mcleinn/openxen/docs/input/lekker-1.jpg

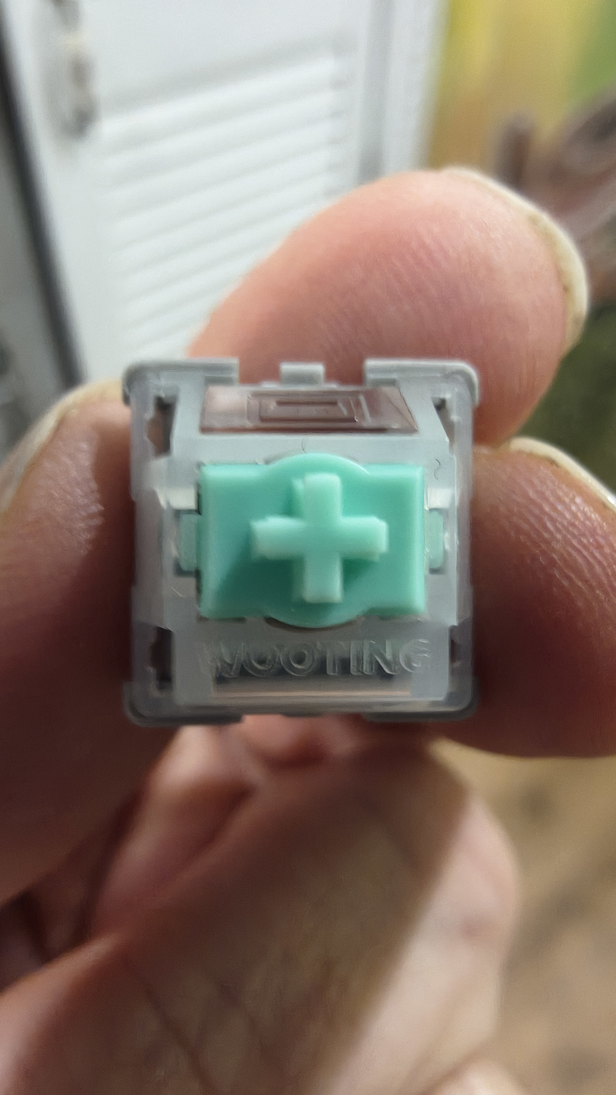
docs/input/lekker-1.jpg
