mcleinn/openxen/docs/input/lekker-2.jpg

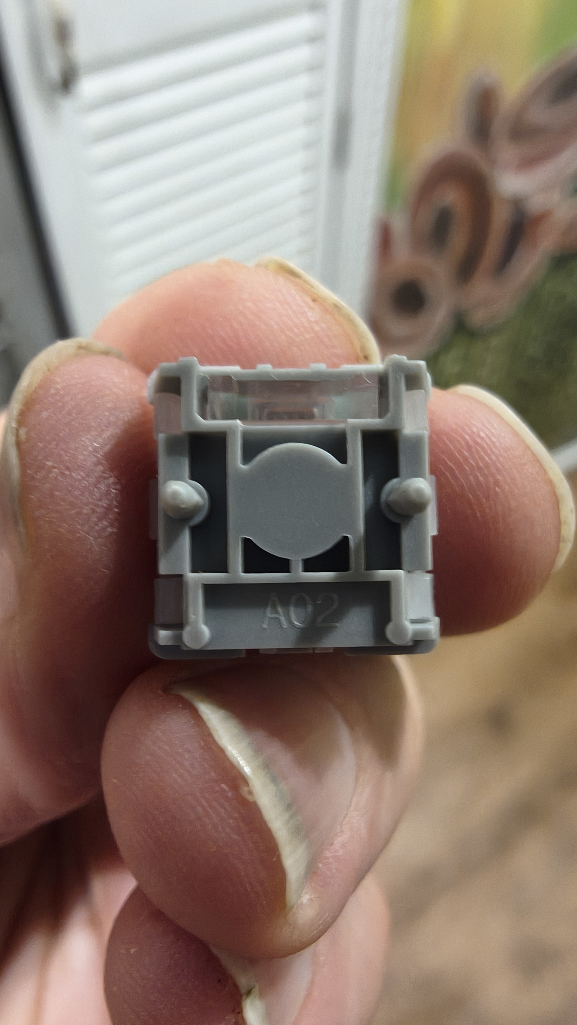
docs/input/lekker-2.jpg
