mcleinn/openxen/case/README.md

# case — deltas against the freexen case

The wood case and the five 1.5 mm CNC plates from freexen are reused. This folder will hold only what changes: floor-plate thickness, USB-C bay cutouts, printed spacers.
