mcleinn/openxen/host/README.md

# host — xentool backend notes

The host code lives in `C:\Dev-Free\xentool` (new `src/openxen/` backend, Phase 8). This folder holds the protocol description shared between firmware and host once defined.
