mcleinn/openxen/docs/input/case-1.jpg

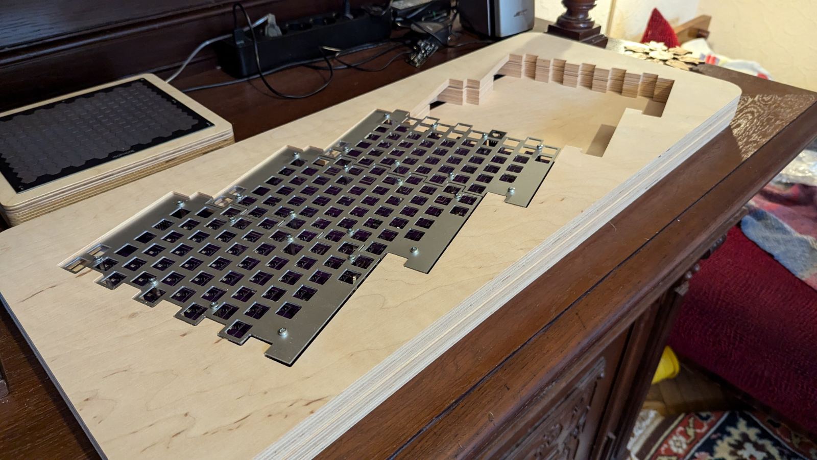
docs/input/case-1.jpg
