mcleinn/openxen/docs/input/case-2.jpg

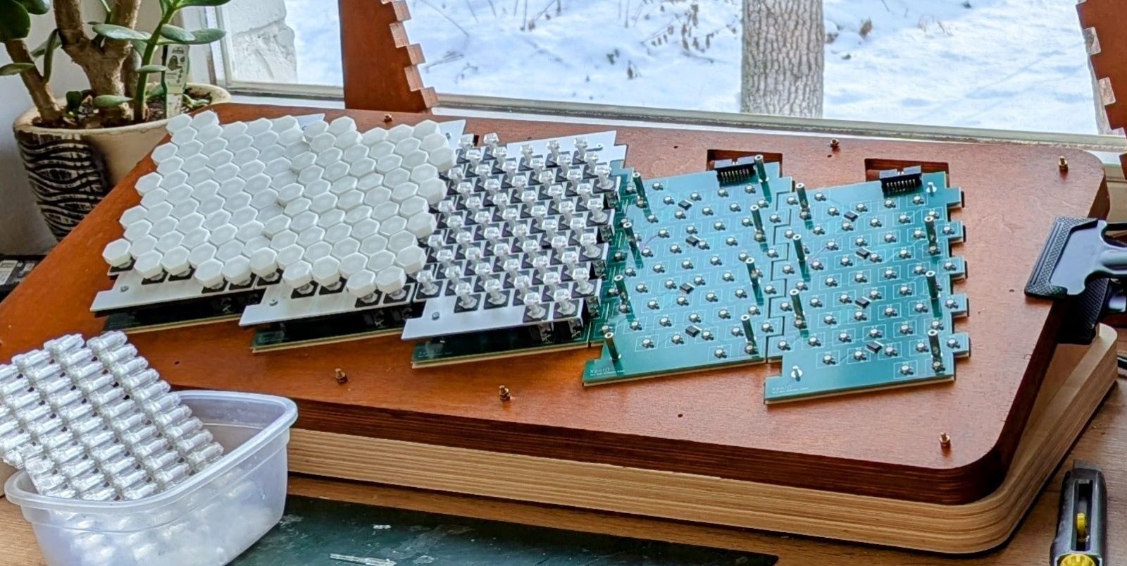
docs/input/case-2.jpg
