mcleinn/openxen/layout/geometry_check.png

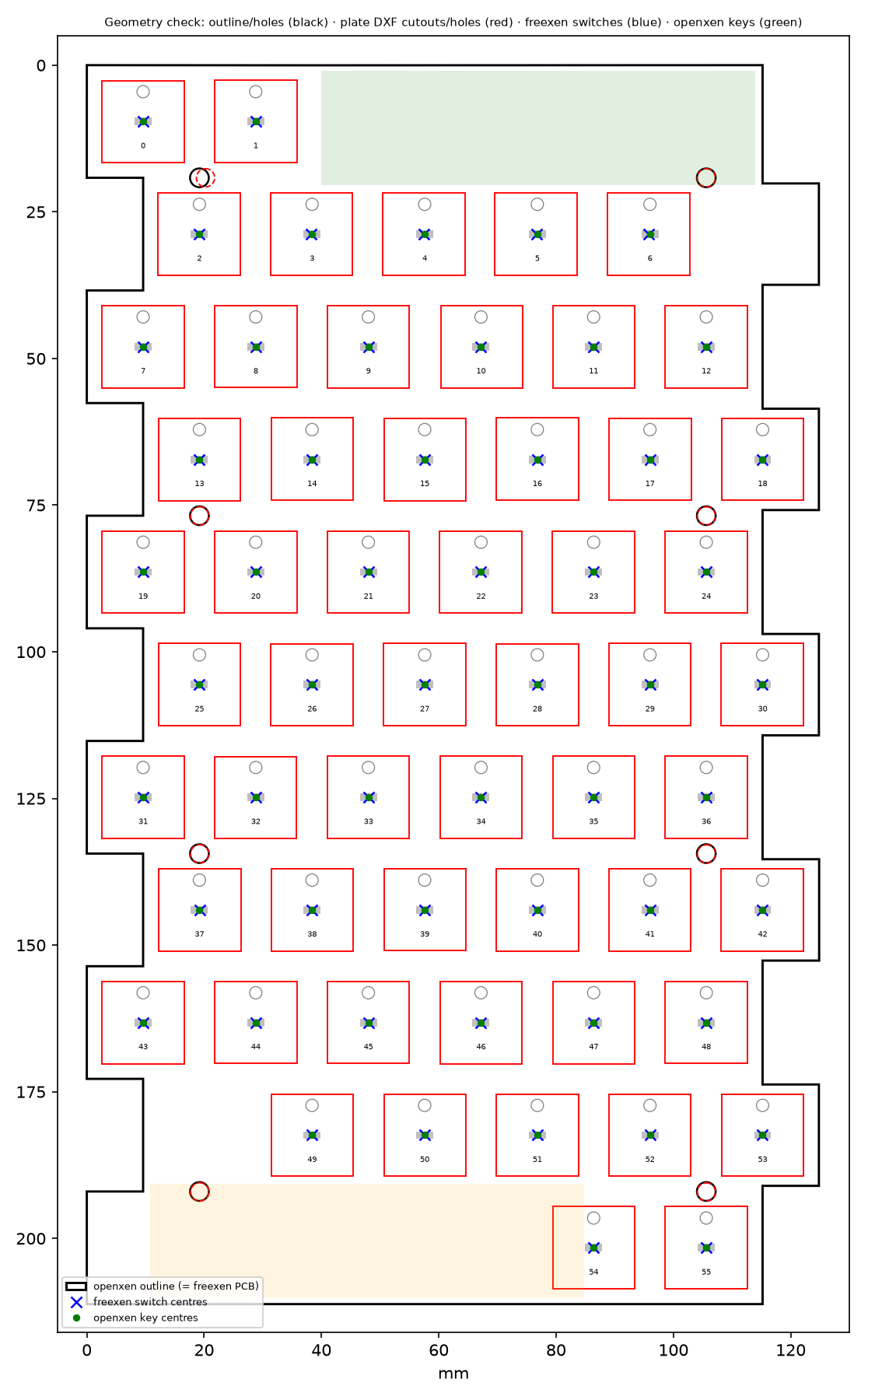
layout/geometry_check.png
