mcleinn/openxen/layout/module_preview.png

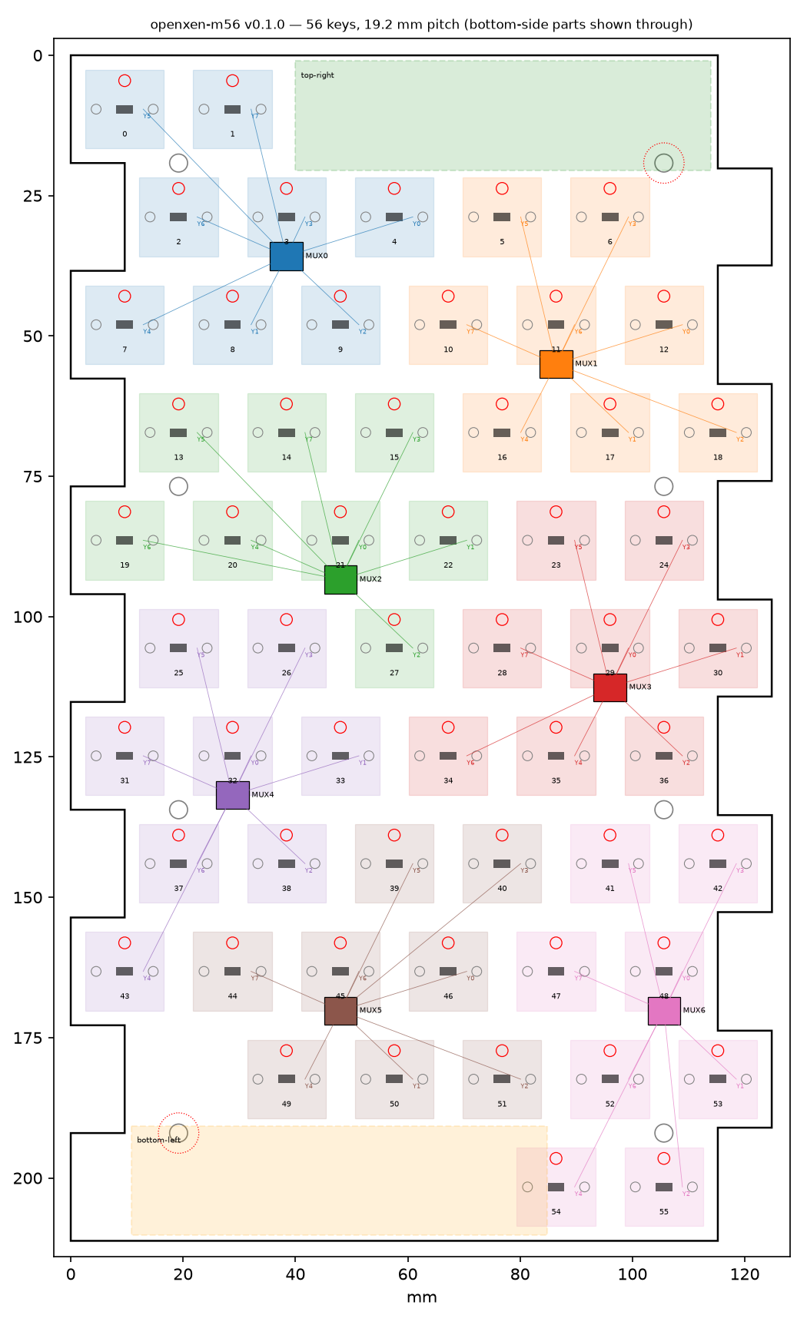
layout/module_preview.png
