mcleinn/openxen/hardware/kicad/openxen-m56/openxen-m56.kicad_pcb

## KiCad design hardware/kicad/openxen-m56/openxen-m56.kicad_pcb (2026-11-07)

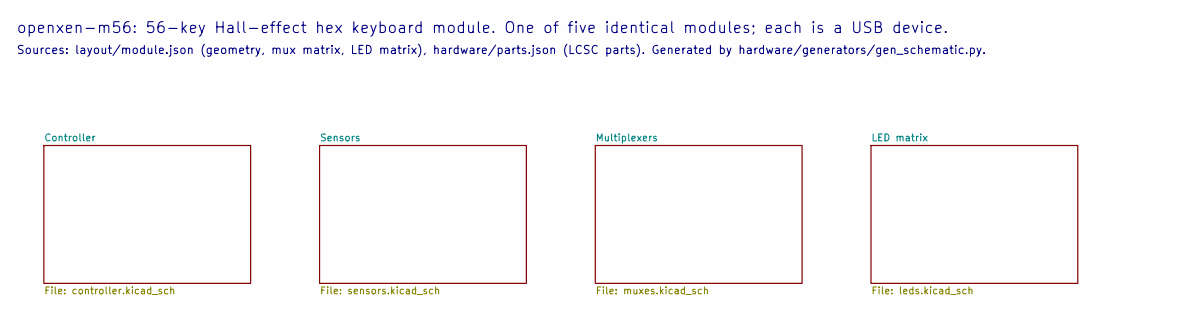
[picture p7: schematic openxen-m56.kicad_sch, openxen-m56 module]

Notes on the sheet:
openxen-m56: 56-key Hall-effect hex keyboard module. One of five identical modules; each is a USB device.
Sources: layout/module.json (geometry, mux matrix, LED matrix), hardware/parts.json (LCSC parts). Generated by hardware/generators/gen_schematic.py.

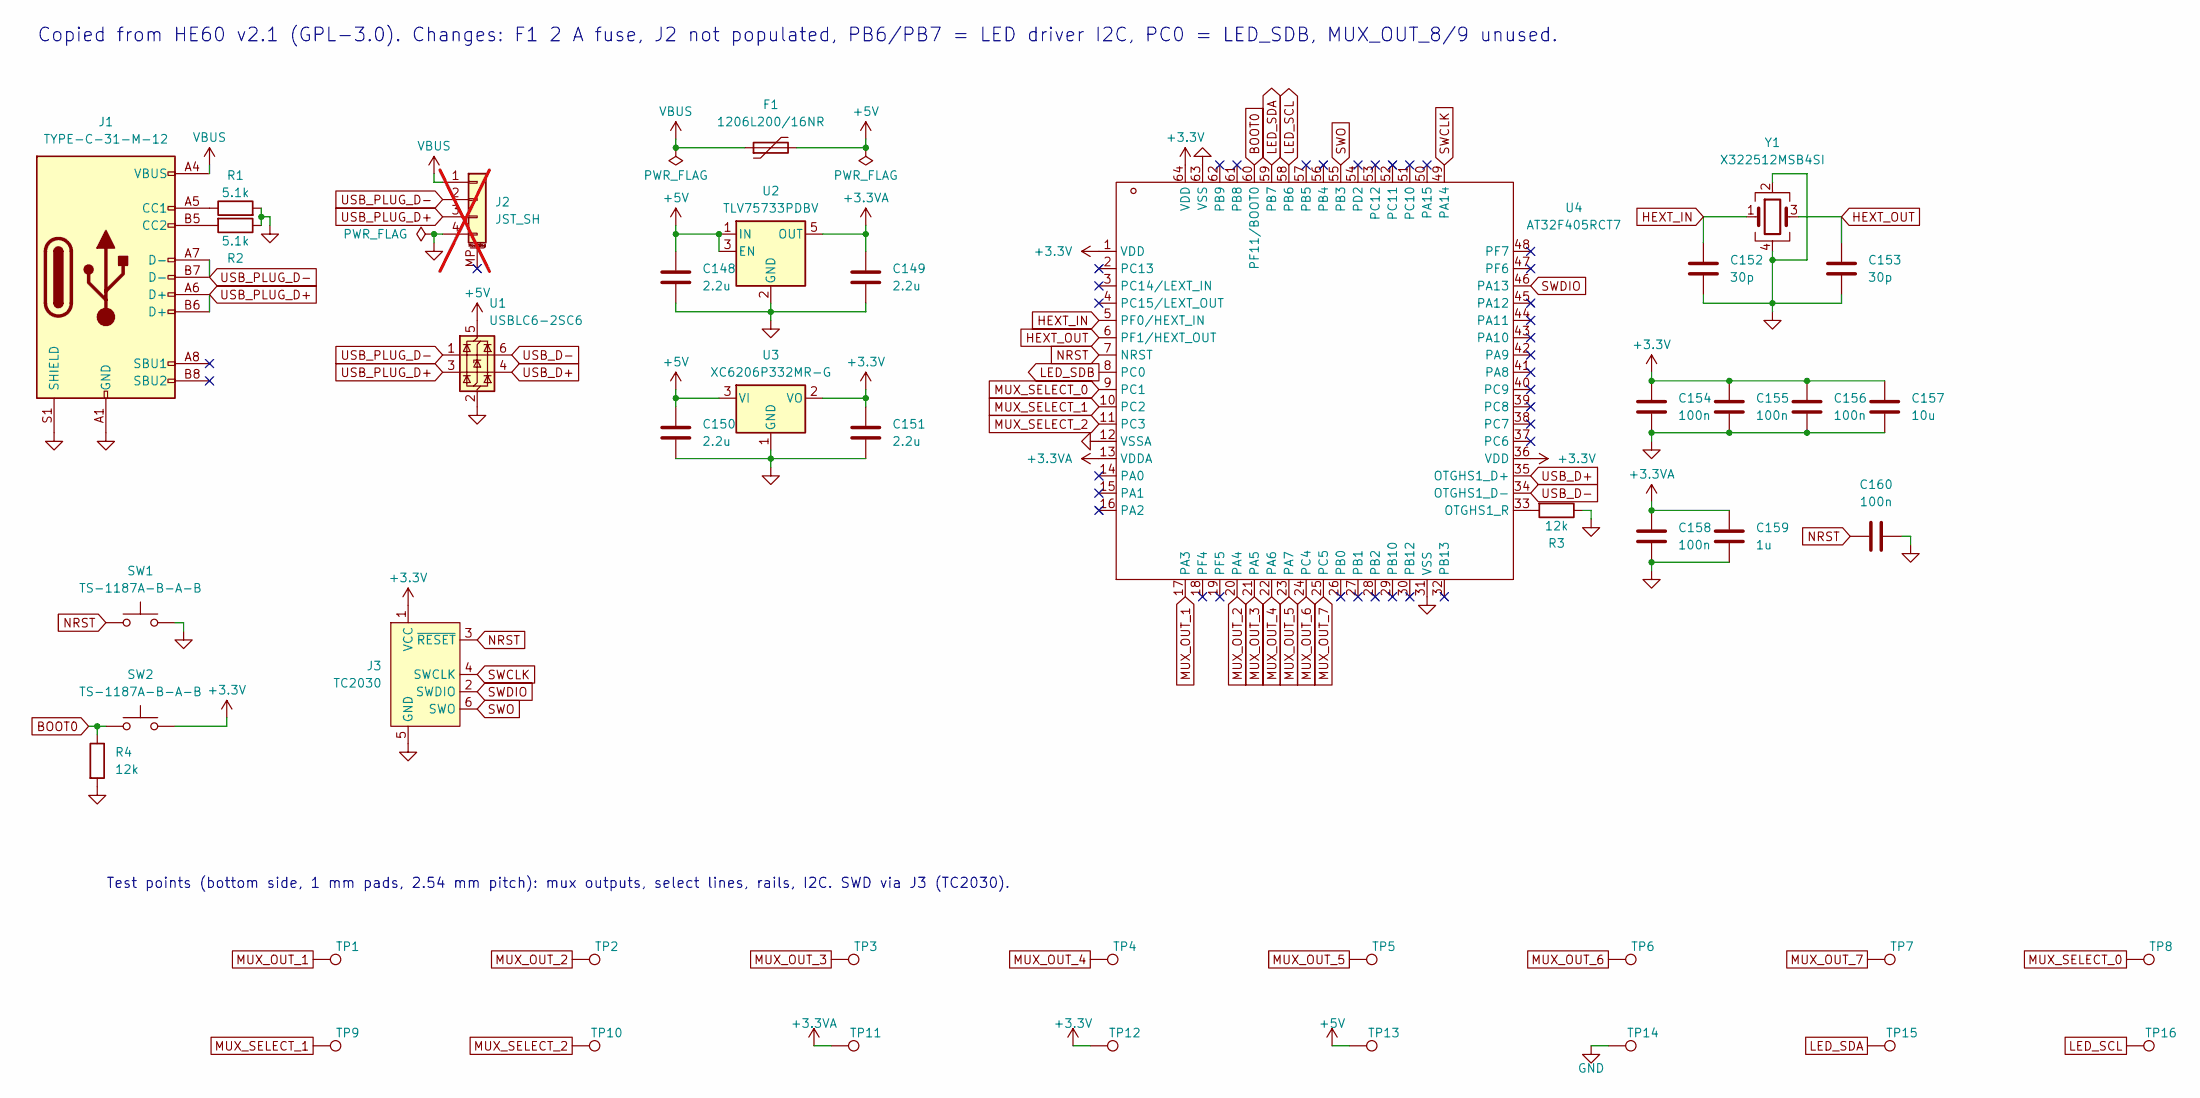
[picture p8: schematic controller.kicad_sch, openxen-m56 - Controller]

Parts:
C148, C149, C150, C151: 2.2u; C_0603_1608Metric; MPN CL10A225KO8NNNC; LCSC Part # C23630
C152, C153: 30p; C_0603_1608Metric; MPN 0603CG300J500NT; LCSC Part # C1658
C154, C155, C156, C158, C160: 100n; C_0402_1005Metric; MPN CL05B104KO5NNNC; LCSC Part # C1525
C157: 10u; C_0603_1608Metric; MPN CL10A106KP8NNNC; LCSC Part # C19702
C159: 1u; C_0603_1608Metric; MPN CL10A105KB8NNNC; LCSC Part # C15849
F1: 1206L200/16NR; Fuse_1206_3216Metric; MPN 1206L200/16NR; LCSC Part # C22374899
J1: TYPE-C-31-M-12; USB_C_Receptacle_HRO_TYPE-C-31-M-12; MPN TYPE-C-31-M-12; LCSC Part # C165948
J2: JST_SH; JST_SH_SM04B-SRSS-TB_1x04-1MP_P1.00mm_Horizontal; MPN SM04B-SRSS-TB(LF)(SN); LCSC Part # C160404; not fitted
J3: TC2030; Tag-Connect_TC2030-IDC-FP_2x03_P1.27mm_Vertical
R1, R2: 5.1k; R_0402_1005Metric; MPN 0402WGF5101TCE; LCSC Part # C25905
R3, R4: 12k; R_0402_1005Metric; MPN 0402WGF1202TCE; LCSC Part # C25752
SW1, SW2: TS-1187A-B-A-B; SW_Push_1P1T_XKB_TS-1187A; MPN TS-1187A-B-A-B; LCSC Part # C318884
TP1: MUX_OUT_1; TestPoint_Pad_D1.0mm
TP2: MUX_OUT_2; TestPoint_Pad_D1.0mm
TP3: MUX_OUT_3; TestPoint_Pad_D1.0mm
TP4: MUX_OUT_4; TestPoint_Pad_D1.0mm
TP5: MUX_OUT_5; TestPoint_Pad_D1.0mm
TP6: MUX_OUT_6; TestPoint_Pad_D1.0mm
TP7: MUX_OUT_7; TestPoint_Pad_D1.0mm
TP8: MUX_SELECT_0; TestPoint_Pad_D1.0mm
TP9: MUX_SELECT_1; TestPoint_Pad_D1.0mm
TP10: MUX_SELECT_2; TestPoint_Pad_D1.0mm
TP11: +3.3VA; TestPoint_Pad_D1.0mm
TP12: +3.3V; TestPoint_Pad_D1.0mm
TP13: +5V; TestPoint_Pad_D1.0mm
TP14: GND; TestPoint_Pad_D1.0mm
TP15: LED_SDA; TestPoint_Pad_D1.0mm
TP16: LED_SCL; TestPoint_Pad_D1.0mm
U1: USBLC6-2SC6; SOT-23-6; MPN USBLC6-2SC6; LCSC Part # C7519
U2: TLV75733PDBV; SOT-23-5; MPN TLV75733PDBVR; LCSC Part # C485517
U3: XC6206P332MR-G; SOT-23; MPN XC6206P332MR-G; LCSC Part # C5446
U4: AT32F405RCT7; LQFP-64_10x10mm_P0.5mm; MPN AT32F405RCT7; LCSC Part # C47090415
Y1: X322512MSB4SI; Crystal_SMD_3225-4Pin_3.2x2.5mm; MPN X322512MSB4SI; LCSC Part # C9002

Connections:
+3.3V: C151.1, C154.1, C155.1, C156.1, C157.1, J3.1 (VCC), SW2.2, TP12.1, U3.2 (VO), U4.1 (VDD), U4.36 (VDD), U4.64 (VDD); also elsewhere on the board
+3.3VA: C149.1, C158.1, C159.1, TP11.1, U2.5 (OUT), U4.13 (VDDA); also elsewhere on the board
+5V: C148.1, C150.1, F1.2, TP13.1, U1.5 (VBUS), U2.1 (IN), U2.3 (EN), U3.3 (VI); also elsewhere on the board
BOOT0: R4.1, SW2.1, U4.60 (PF11/BOOT0)
GND: C148.2, C149.2, C150.2, C151.2, C152.2, C153.2, C154.2, C155.2, C156.2, C157.2, C158.2, C159.2, C160.2, J1.A1 (GND), J1.A12 (GND), J1.B1 (GND), J1.B12 (GND), J1.S1 (SHIELD), J2.4, J3.5 (GND), R1.2, R2.1, R3.1, R4.2, SW1.2, TP14.1, U1.2 (GND), U2.2 (GND), U3.1 (GND), U4.12 (VSSA), U4.31 (VSS), U4.63 (VSS), Y1.2, Y1.4; also elsewhere on the board
HEXT_IN: C152.1, U4.5 (PF0/HEXT_IN), Y1.1
HEXT_OUT: C153.1, U4.6 (PF1/HEXT_OUT), Y1.3
LED_SCL: TP16.1, U4.58 (PB6); also elsewhere on the board
LED_SDA: TP15.1, U4.59 (PB7); also elsewhere on the board
LED_SDB: U4.8 (PC0); also elsewhere on the board
MUX_OUT_1: TP1.1, U4.17 (PA3); also elsewhere on the board
MUX_OUT_2: TP2.1, U4.20 (PA4); also elsewhere on the board
MUX_OUT_3: TP3.1, U4.21 (PA5); also elsewhere on the board
MUX_OUT_4: TP4.1, U4.22 (PA6); also elsewhere on the board
MUX_OUT_5: TP5.1, U4.23 (PA7); also elsewhere on the board
MUX_OUT_6: TP6.1, U4.24 (PC4); also elsewhere on the board
MUX_OUT_7: TP7.1, U4.25 (PC5); also elsewhere on the board
MUX_SELECT_0: TP8.1, U4.9 (PC1); also elsewhere on the board
MUX_SELECT_1: TP9.1, U4.10 (PC2); also elsewhere on the board
MUX_SELECT_2: TP10.1, U4.11 (PC3); also elsewhere on the board
NRST: C160.1, J3.3 (~RESET), SW1.1, U4.7 (NRST)
unnamed: J1.A5 (CC1), R1.1
unnamed: J1.B5 (CC2), R2.2
unnamed: R3.2, U4.33 (OTGHS1_R)
SWCLK: J3.4 (SWCLK), U4.49 (PA14)
SWDIO: J3.2 (SWDIO), U4.46 (PA13)
SWO: J3.6 (SWO), U4.55 (PB3)
USB_D+: U1.4 (I/O2), U4.35 (OTGHS1_D+)
USB_D-: U1.6 (I/O1), U4.34 (OTGHS1_D-)
USB_PLUG_D+: J1.A6 (D+), J1.B6 (D+), J2.3, U1.3 (I/O2)
USB_PLUG_D-: J1.A7 (D-), J1.B7 (D-), J2.2, U1.1 (I/O1)
VBUS: F1.1, J1.A4 (VBUS), J1.A9 (VBUS), J1.B4 (VBUS), J1.B9 (VBUS), J2.1

Notes on the sheet:
Copied from HE60 v2.1 (GPL-3.0). Changes: F1 2 A fuse, J2 not populated, PB6/PB7 = LED driver I2C, PC0 = LED_SDB, MUX_OUT_8/9 unused.
Test points (bottom side, 1 mm pads, 2.54 mm pitch): mux outputs, select lines, rails, I2C. SWD via J3 (TC2030).

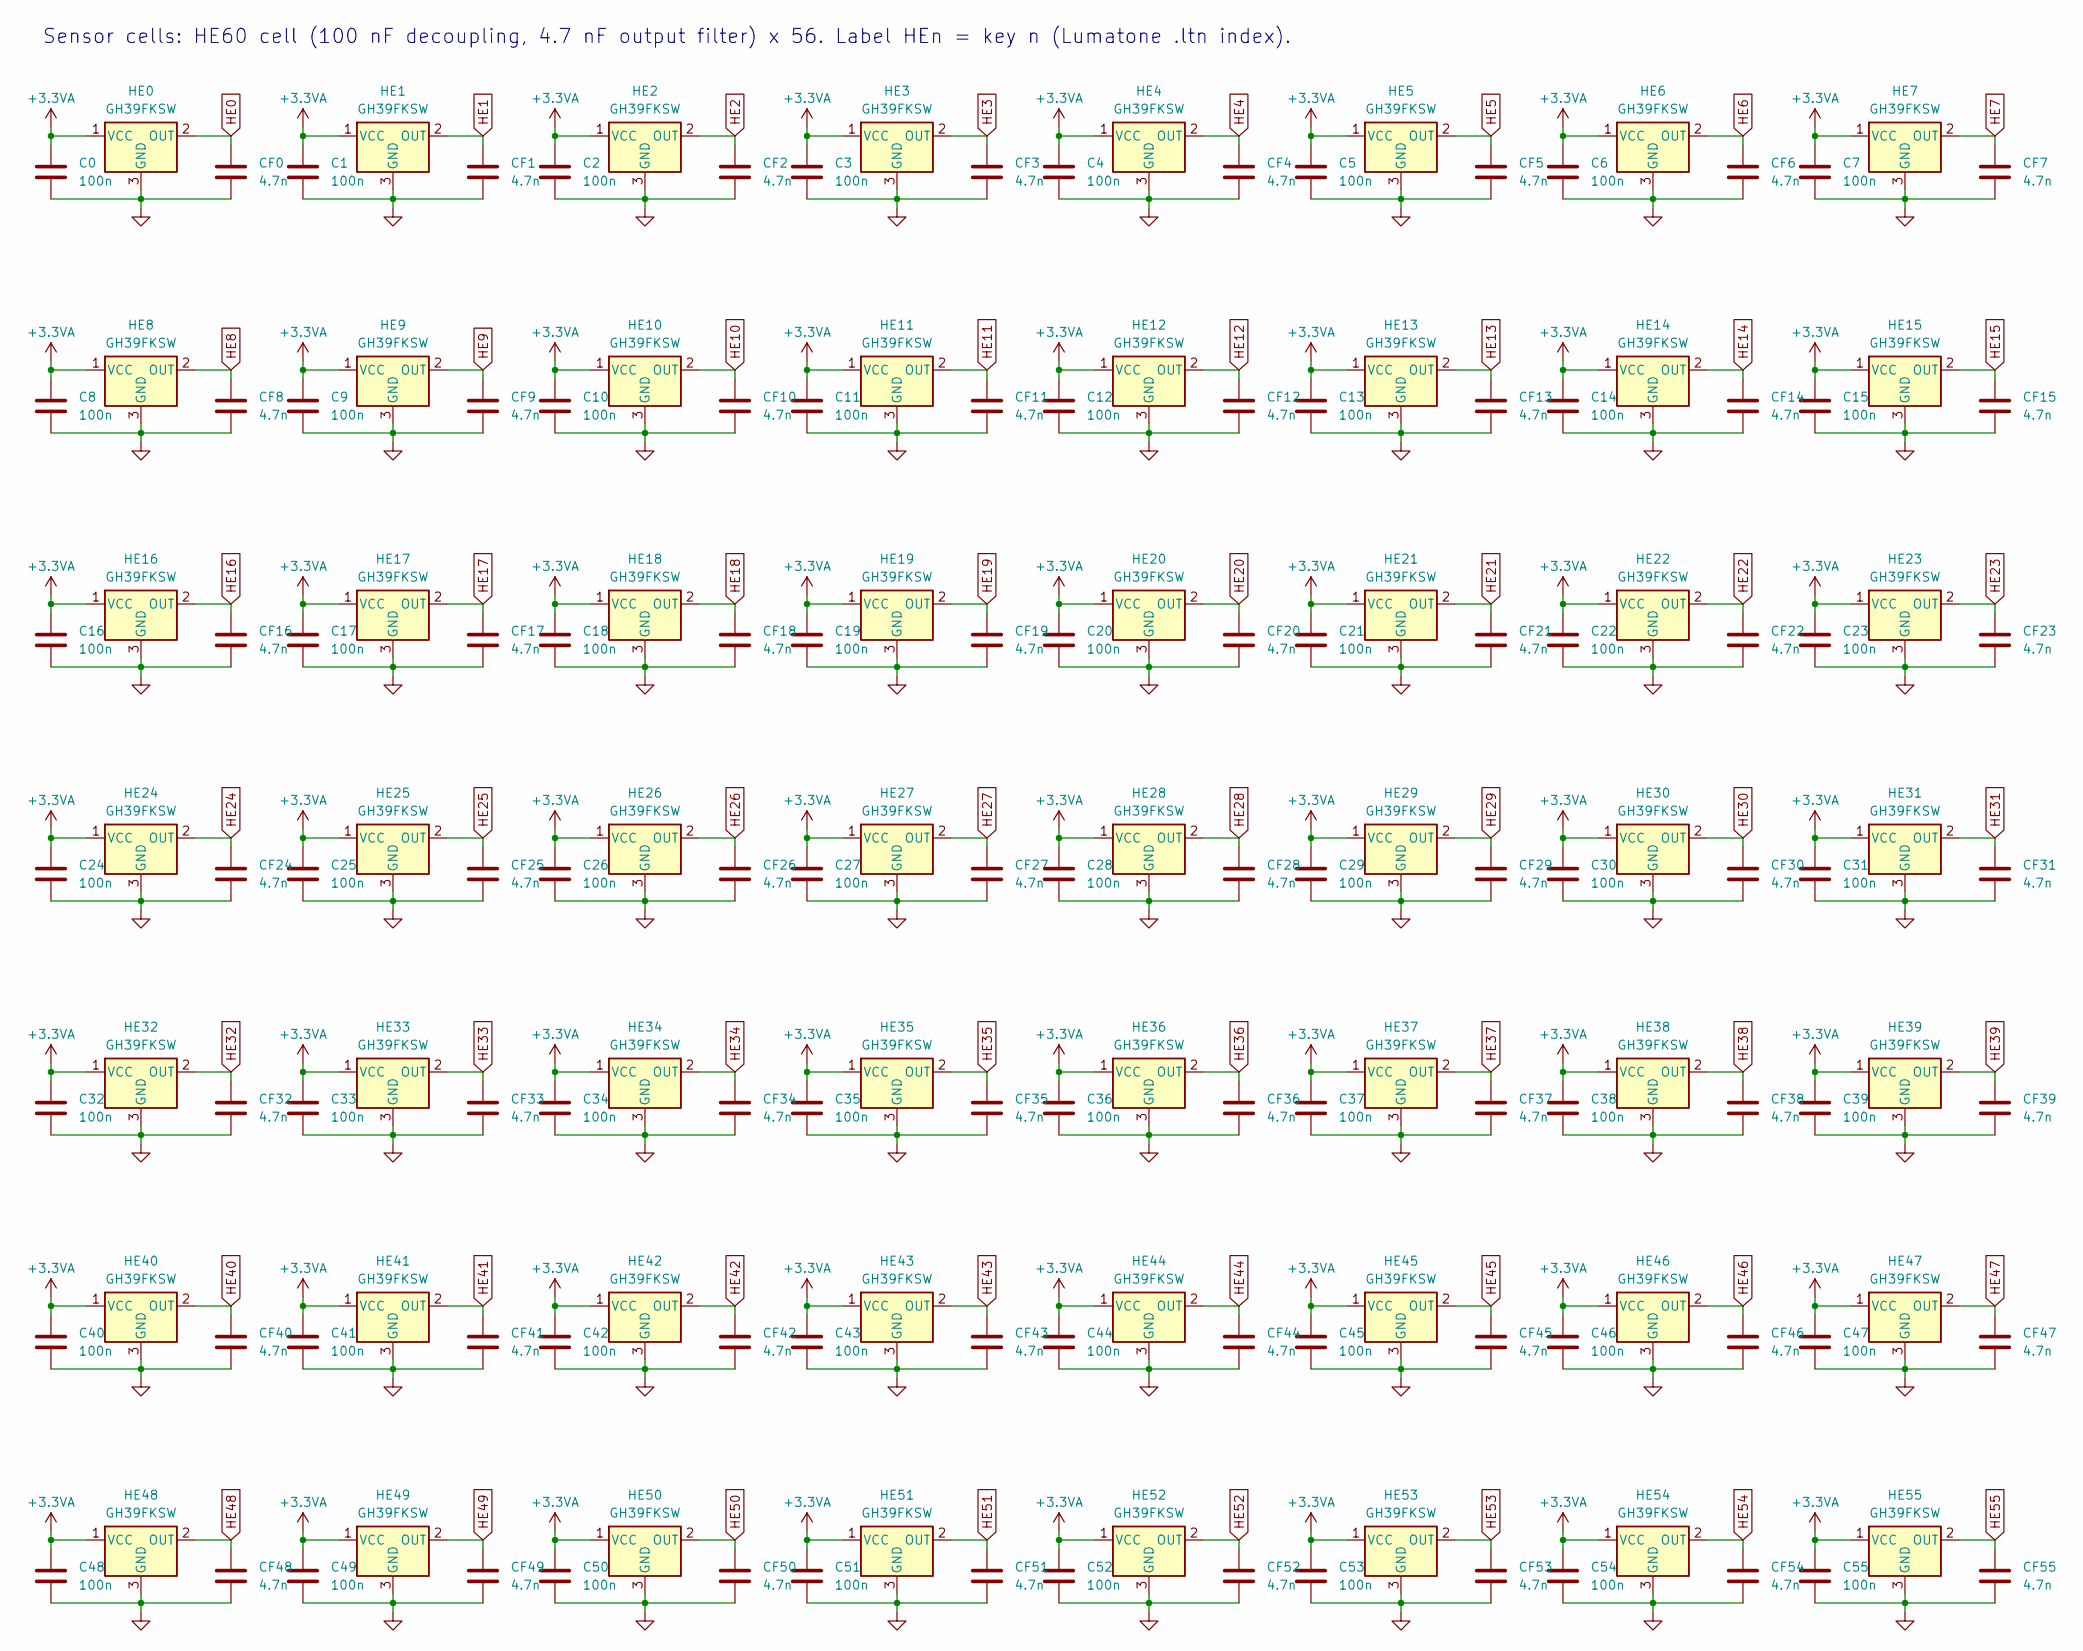
[picture p9: schematic sensors.kicad_sch, openxen-m56 - Sensors]

Parts:
C0, C1, C2, C3, C4, C5, C6, C7, C8, C9, C10, C11, C12, C13, C14, C15, C16, C17, C18, C19, C20, C21, C22, C23, C24, C25, C26, C27, C28, C29, C30, C31, C32, C33, C34, C35, C36, C37, C38, C39, C40, C41, C42, C43, C44, C45, C46, C47, C48, C49, C50, C51, C52, C53, C54, C55: 100n; C_0402_1005Metric; MPN CL05B104KO5NNNC; LCSC Part # C1525
CF0, CF1, CF2, CF3, CF4, CF5, CF6, CF7, CF8, CF9, CF10, CF11, CF12, CF13, CF14, CF15, CF16, CF17, CF18, CF19, CF20, CF21, CF22, CF23, CF24, CF25, CF26, CF27, CF28, CF29, CF30, CF31, CF32, CF33, CF34, CF35, CF36, CF37, CF38, CF39, CF40, CF41, CF42, CF43, CF44, CF45, CF46, CF47, CF48, CF49, CF50, CF51, CF52, CF53, CF54, CF55: 4.7n; C_0402_1005Metric; MPN 0402B472K500NT; LCSC Part # C1538
HE0, HE1, HE2, HE3, HE4, HE5, HE6, HE7, HE8, HE9, HE10, HE11, HE12, HE13, HE14, HE15, HE16, HE17, HE18, HE19, HE20, HE21, HE22, HE23, HE24, HE25, HE26, HE27, HE28, HE29, HE30, HE31, HE32, HE33, HE34, HE35, HE36, HE37, HE38, HE39, HE40, HE41, HE42, HE43, HE44, HE45, HE46, HE47, HE48, HE49, HE50, HE51, HE52, HE53, HE54, HE55: GH39FKSW; SOT-23; MPN GH39FKSW; LCSC Part # C266230

Connections:
+3.3VA: C0.1, C1.1, C2.1, C3.1, C4.1, C5.1, C6.1, C7.1, C8.1, C9.1, C10.1, C11.1, C12.1, C13.1, C14.1, C15.1, C16.1, C17.1, C18.1, C19.1, C20.1, C21.1, C22.1, C23.1, C24.1, C25.1, C26.1, C27.1, C28.1, C29.1, C30.1, C31.1, C32.1, C33.1, C34.1, C35.1, C36.1, C37.1, C38.1, C39.1, C40.1, C41.1, C42.1, C43.1, C44.1, C45.1, C46.1, C47.1, C48.1, C49.1, C50.1, C51.1, C52.1, C53.1, C54.1, C55.1, HE0.1 (VCC), HE1.1 (VCC), HE2.1 (VCC), HE3.1 (VCC), HE4.1 (VCC), HE5.1 (VCC), HE6.1 (VCC), HE7.1 (VCC), HE8.1 (VCC), HE9.1 (VCC), HE10.1 (VCC), HE11.1 (VCC), HE12.1 (VCC), HE13.1 (VCC), HE14.1 (VCC), HE15.1 (VCC), HE16.1 (VCC), HE17.1 (VCC), HE18.1 (VCC), HE19.1 (VCC), HE20.1 (VCC), HE21.1 (VCC), HE22.1 (VCC), HE23.1 (VCC), HE24.1 (VCC), HE25.1 (VCC), HE26.1 (VCC), HE27.1 (VCC), HE28.1 (VCC), HE29.1 (VCC), HE30.1 (VCC), HE31.1 (VCC), HE32.1 (VCC), HE33.1 (VCC), HE34.1 (VCC), HE35.1 (VCC), HE36.1 (VCC), HE37.1 (VCC), HE38.1 (VCC), HE39.1 (VCC), HE40.1 (VCC), HE41.1 (VCC), HE42.1 (VCC), HE43.1 (VCC), HE44.1 (VCC), HE45.1 (VCC), HE46.1 (VCC), HE47.1 (VCC), HE48.1 (VCC), HE49.1 (VCC), HE50.1 (VCC), HE51.1 (VCC), HE52.1 (VCC), HE53.1 (VCC), HE54.1 (VCC), HE55.1 (VCC); also elsewhere on the board
GND: C0.2, C1.2, C2.2, C3.2, C4.2, C5.2, C6.2, C7.2, C8.2, C9.2, C10.2, C11.2, C12.2, C13.2, C14.2, C15.2, C16.2, C17.2, C18.2, C19.2, C20.2, C21.2, C22.2, C23.2, C24.2, C25.2, C26.2, C27.2, C28.2, C29.2, C30.2, C31.2, C32.2, C33.2, C34.2, C35.2, C36.2, C37.2, C38.2, C39.2, C40.2, C41.2, C42.2, C43.2, C44.2, C45.2, C46.2, C47.2, C48.2, C49.2, C50.2, C51.2, C52.2, C53.2, C54.2, C55.2, CF0.2, CF1.2, CF2.2, CF3.2, CF4.2, CF5.2, CF6.2, CF7.2, CF8.2, CF9.2, CF10.2, CF11.2, CF12.2, CF13.2, CF14.2, CF15.2, CF16.2, CF17.2, CF18.2, CF19.2, CF20.2, CF21.2, CF22.2, CF23.2, CF24.2, CF25.2, CF26.2, CF27.2, CF28.2, CF29.2, CF30.2, CF31.2, CF32.2, CF33.2, CF34.2, CF35.2, CF36.2, CF37.2, CF38.2, CF39.2, CF40.2, CF41.2, CF42.2, CF43.2, CF44.2, CF45.2, CF46.2, CF47.2, CF48.2, CF49.2, CF50.2, CF51.2, CF52.2, CF53.2, CF54.2, CF55.2, HE0.3 (GND), HE1.3 (GND), HE2.3 (GND), HE3.3 (GND), HE4.3 (GND), HE5.3 (GND), HE6.3 (GND), HE7.3 (GND), HE8.3 (GND), HE9.3 (GND), HE10.3 (GND), HE11.3 (GND), HE12.3 (GND), HE13.3 (GND), HE14.3 (GND), HE15.3 (GND), HE16.3 (GND), HE17.3 (GND), HE18.3 (GND), HE19.3 (GND), HE20.3 (GND), HE21.3 (GND), HE22.3 (GND), HE23.3 (GND), HE24.3 (GND), HE25.3 (GND), HE26.3 (GND), HE27.3 (GND), HE28.3 (GND), HE29.3 (GND), HE30.3 (GND), HE31.3 (GND), HE32.3 (GND), HE33.3 (GND), HE34.3 (GND), HE35.3 (GND), HE36.3 (GND), HE37.3 (GND), HE38.3 (GND), HE39.3 (GND), HE40.3 (GND), HE41.3 (GND), HE42.3 (GND), HE43.3 (GND), HE44.3 (GND), HE45.3 (GND), HE46.3 (GND), HE47.3 (GND), HE48.3 (GND), HE49.3 (GND), HE50.3 (GND), HE51.3 (GND), HE52.3 (GND), HE53.3 (GND), HE54.3 (GND), HE55.3 (GND); also elsewhere on the board
HE0: CF0.1, HE0.2 (OUT); also elsewhere on the board
HE1: CF1.1, HE1.2 (OUT); also elsewhere on the board
HE2: CF2.1, HE2.2 (OUT); also elsewhere on the board
HE3: CF3.1, HE3.2 (OUT); also elsewhere on the board
HE4: CF4.1, HE4.2 (OUT); also elsewhere on the board
HE5: CF5.1, HE5.2 (OUT); also elsewhere on the board
HE6: CF6.1, HE6.2 (OUT); also elsewhere on the board
HE7: CF7.1, HE7.2 (OUT); also elsewhere on the board
HE8: CF8.1, HE8.2 (OUT); also elsewhere on the board
HE9: CF9.1, HE9.2 (OUT); also elsewhere on the board
HE10: CF10.1, HE10.2 (OUT); also elsewhere on the board
HE11: CF11.1, HE11.2 (OUT); also elsewhere on the board
HE12: CF12.1, HE12.2 (OUT); also elsewhere on the board
HE13: CF13.1, HE13.2 (OUT); also elsewhere on the board
HE14: CF14.1, HE14.2 (OUT); also elsewhere on the board
HE15: CF15.1, HE15.2 (OUT); also elsewhere on the board
HE16: CF16.1, HE16.2 (OUT); also elsewhere on the board
HE17: CF17.1, HE17.2 (OUT); also elsewhere on the board
HE18: CF18.1, HE18.2 (OUT); also elsewhere on the board
HE19: CF19.1, HE19.2 (OUT); also elsewhere on the board
HE20: CF20.1, HE20.2 (OUT); also elsewhere on the board
HE21: CF21.1, HE21.2 (OUT); also elsewhere on the board
HE22: CF22.1, HE22.2 (OUT); also elsewhere on the board
HE23: CF23.1, HE23.2 (OUT); also elsewhere on the board
HE24: CF24.1, HE24.2 (OUT); also elsewhere on the board
HE25: CF25.1, HE25.2 (OUT); also elsewhere on the board
HE26: CF26.1, HE26.2 (OUT); also elsewhere on the board
HE27: CF27.1, HE27.2 (OUT); also elsewhere on the board
HE28: CF28.1, HE28.2 (OUT); also elsewhere on the board
HE29: CF29.1, HE29.2 (OUT); also elsewhere on the board
HE30: CF30.1, HE30.2 (OUT); also elsewhere on the board
HE31: CF31.1, HE31.2 (OUT); also elsewhere on the board
HE32: CF32.1, HE32.2 (OUT); also elsewhere on the board
HE33: CF33.1, HE33.2 (OUT); also elsewhere on the board
HE34: CF34.1, HE34.2 (OUT); also elsewhere on the board
HE35: CF35.1, HE35.2 (OUT); also elsewhere on the board
HE36: CF36.1, HE36.2 (OUT); also elsewhere on the board
HE37: CF37.1, HE37.2 (OUT); also elsewhere on the board
HE38: CF38.1, HE38.2 (OUT); also elsewhere on the board
HE39: CF39.1, HE39.2 (OUT); also elsewhere on the board
HE40: CF40.1, HE40.2 (OUT); also elsewhere on the board
HE41: CF41.1, HE41.2 (OUT); also elsewhere on the board
HE42: CF42.1, HE42.2 (OUT); also elsewhere on the board
HE43: CF43.1, HE43.2 (OUT); also elsewhere on the board
HE44: CF44.1, HE44.2 (OUT); also elsewhere on the board
HE45: CF45.1, HE45.2 (OUT); also elsewhere on the board
HE46: CF46.1, HE46.2 (OUT); also elsewhere on the board
HE47: CF47.1, HE47.2 (OUT); also elsewhere on the board
HE48: CF48.1, HE48.2 (OUT); also elsewhere on the board
HE49: CF49.1, HE49.2 (OUT); also elsewhere on the board
HE50: CF50.1, HE50.2 (OUT); also elsewhere on the board
HE51: CF51.1, HE51.2 (OUT); also elsewhere on the board
HE52: CF52.1, HE52.2 (OUT); also elsewhere on the board
HE53: CF53.1, HE53.2 (OUT); also elsewhere on the board
HE54: CF54.1, HE54.2 (OUT); also elsewhere on the board
HE55: CF55.1, HE55.2 (OUT); also elsewhere on the board

Notes on the sheet:
Sensor cells: HE60 cell (100 nF decoupling, 4.7 nF output filter) x 56. Label HEn = key n (Lumatone .ltn index).

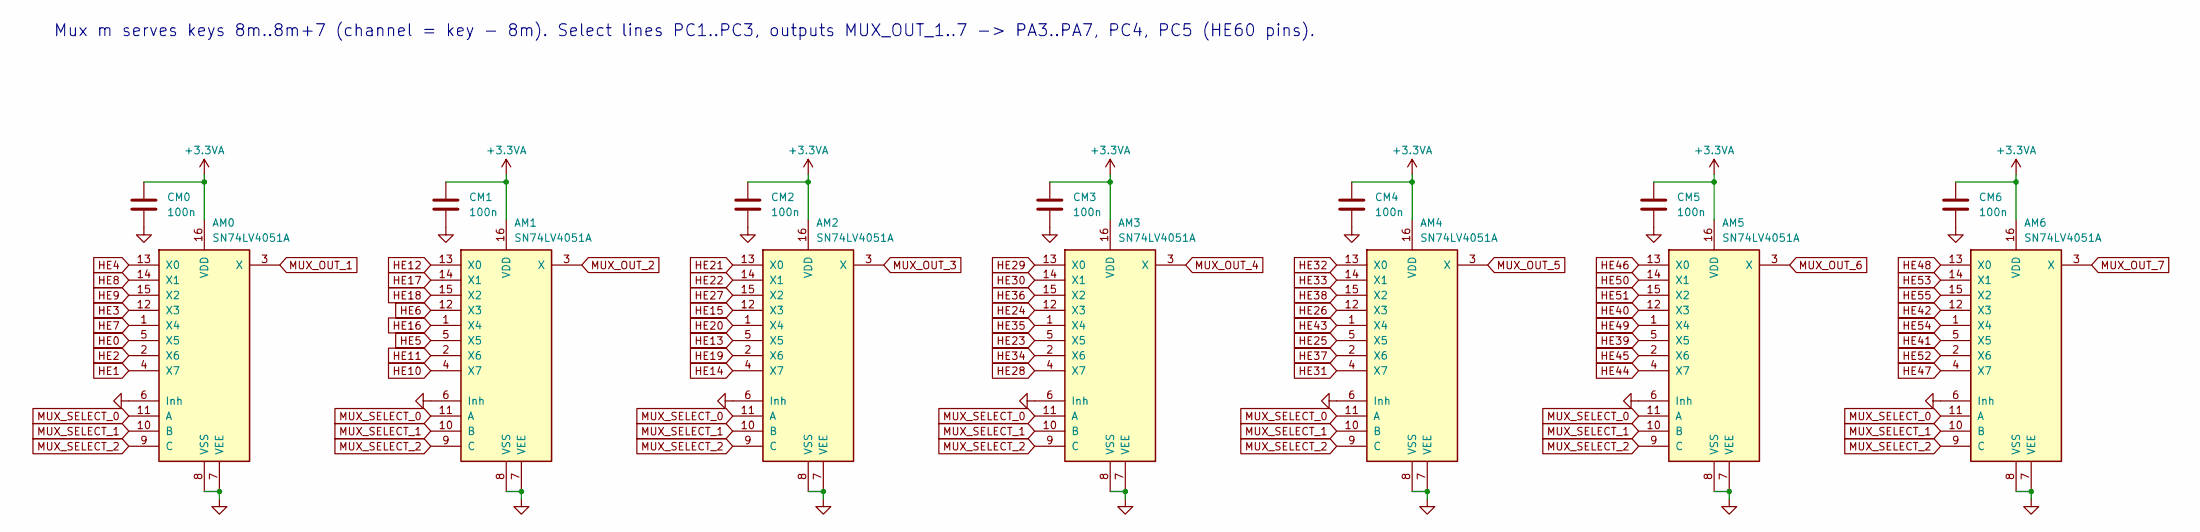
[picture p10: schematic muxes.kicad_sch, openxen-m56 - Multiplexers]

Parts:
AM0, AM1, AM2, AM3, AM4, AM5, AM6: SN74LV4051A; TSSOP-16_4.4x5mm_P0.65mm; MPN SN74LV4051APWR; LCSC Part # C7793
CM0, CM1, CM2, CM3, CM4, CM5, CM6: 100n; C_0402_1005Metric; MPN CL05B104KO5NNNC; LCSC Part # C1525

Connections:
+3.3VA: AM0.16 (VDD), AM1.16 (VDD), AM2.16 (VDD), AM3.16 (VDD), AM4.16 (VDD), AM5.16 (VDD), AM6.16 (VDD), CM0.1, CM1.1, CM2.1, CM3.1, CM4.1, CM5.1, CM6.1; also elsewhere on the board
GND: AM0.6 (Inh), AM0.7 (VEE), AM0.8 (VSS), AM1.6 (Inh), AM1.7 (VEE), AM1.8 (VSS), AM2.6 (Inh), AM2.7 (VEE), AM2.8 (VSS), AM3.6 (Inh), AM3.7 (VEE), AM3.8 (VSS), AM4.6 (Inh), AM4.7 (VEE), AM4.8 (VSS), AM5.6 (Inh), AM5.7 (VEE), AM5.8 (VSS), AM6.6 (Inh), AM6.7 (VEE), AM6.8 (VSS), CM0.2, CM1.2, CM2.2, CM3.2, CM4.2, CM5.2, CM6.2; also elsewhere on the board
HE0: AM0.5 (X5); also elsewhere on the board
HE1: AM0.4 (X7); also elsewhere on the board
HE2: AM0.2 (X6); also elsewhere on the board
HE3: AM0.12 (X3); also elsewhere on the board
HE4: AM0.13 (X0); also elsewhere on the board
HE5: AM1.5 (X5); also elsewhere on the board
HE6: AM1.12 (X3); also elsewhere on the board
HE7: AM0.1 (X4); also elsewhere on the board
HE8: AM0.14 (X1); also elsewhere on the board
HE9: AM0.15 (X2); also elsewhere on the board
HE10: AM1.4 (X7); also elsewhere on the board
HE11: AM1.2 (X6); also elsewhere on the board
HE12: AM1.13 (X0); also elsewhere on the board
HE13: AM2.5 (X5); also elsewhere on the board
HE14: AM2.4 (X7); also elsewhere on the board
HE15: AM2.12 (X3); also elsewhere on the board
HE16: AM1.1 (X4); also elsewhere on the board
HE17: AM1.14 (X1); also elsewhere on the board
HE18: AM1.15 (X2); also elsewhere on the board
HE19: AM2.2 (X6); also elsewhere on the board
HE20: AM2.1 (X4); also elsewhere on the board
HE21: AM2.13 (X0); also elsewhere on the board
HE22: AM2.14 (X1); also elsewhere on the board
HE23: AM3.5 (X5); also elsewhere on the board
HE24: AM3.12 (X3); also elsewhere on the board
HE25: AM4.5 (X5); also elsewhere on the board
HE26: AM4.12 (X3); also elsewhere on the board
HE27: AM2.15 (X2); also elsewhere on the board
HE28: AM3.4 (X7); also elsewhere on the board
HE29: AM3.13 (X0); also elsewhere on the board
HE30: AM3.14 (X1); also elsewhere on the board
HE31: AM4.4 (X7); also elsewhere on the board
HE32: AM4.13 (X0); also elsewhere on the board
HE33: AM4.14 (X1); also elsewhere on the board
HE34: AM3.2 (X6); also elsewhere on the board
HE35: AM3.1 (X4); also elsewhere on the board
HE36: AM3.15 (X2); also elsewhere on the board
HE37: AM4.2 (X6); also elsewhere on the board
HE38: AM4.15 (X2); also elsewhere on the board
HE39: AM5.5 (X5); also elsewhere on the board
HE40: AM5.12 (X3); also elsewhere on the board
HE41: AM6.5 (X5); also elsewhere on the board
HE42: AM6.12 (X3); also elsewhere on the board
HE43: AM4.1 (X4); also elsewhere on the board
HE44: AM5.4 (X7); also elsewhere on the board
HE45: AM5.2 (X6); also elsewhere on the board
HE46: AM5.13 (X0); also elsewhere on the board
HE47: AM6.4 (X7); also elsewhere on the board
HE48: AM6.13 (X0); also elsewhere on the board
HE49: AM5.1 (X4); also elsewhere on the board
HE50: AM5.14 (X1); also elsewhere on the board
HE51: AM5.15 (X2); also elsewhere on the board
HE52: AM6.2 (X6); also elsewhere on the board
HE53: AM6.14 (X1); also elsewhere on the board
HE54: AM6.1 (X4); also elsewhere on the board
HE55: AM6.15 (X2); also elsewhere on the board
MUX_OUT_1: AM0.3 (X); also elsewhere on the board
MUX_OUT_2: AM1.3 (X); also elsewhere on the board
MUX_OUT_3: AM2.3 (X); also elsewhere on the board
MUX_OUT_4: AM3.3 (X); also elsewhere on the board
MUX_OUT_5: AM4.3 (X); also elsewhere on the board
MUX_OUT_6: AM5.3 (X); also elsewhere on the board
MUX_OUT_7: AM6.3 (X); also elsewhere on the board
MUX_SELECT_0: AM0.11 (A), AM1.11 (A), AM2.11 (A), AM3.11 (A), AM4.11 (A), AM5.11 (A), AM6.11 (A); also elsewhere on the board
MUX_SELECT_1: AM0.10 (B), AM1.10 (B), AM2.10 (B), AM3.10 (B), AM4.10 (B), AM5.10 (B), AM6.10 (B); also elsewhere on the board
MUX_SELECT_2: AM0.9 (C), AM1.9 (C), AM2.9 (C), AM3.9 (C), AM4.9 (C), AM5.9 (C), AM6.9 (C); also elsewhere on the board

Notes on the sheet:
Mux m serves keys 8m..8m+7 (channel = key - 8m). Select lines PC1..PC3, outputs MUX_OUT_1..7 -> PA3..PA7, PC4, PC5 (HE60 pins).

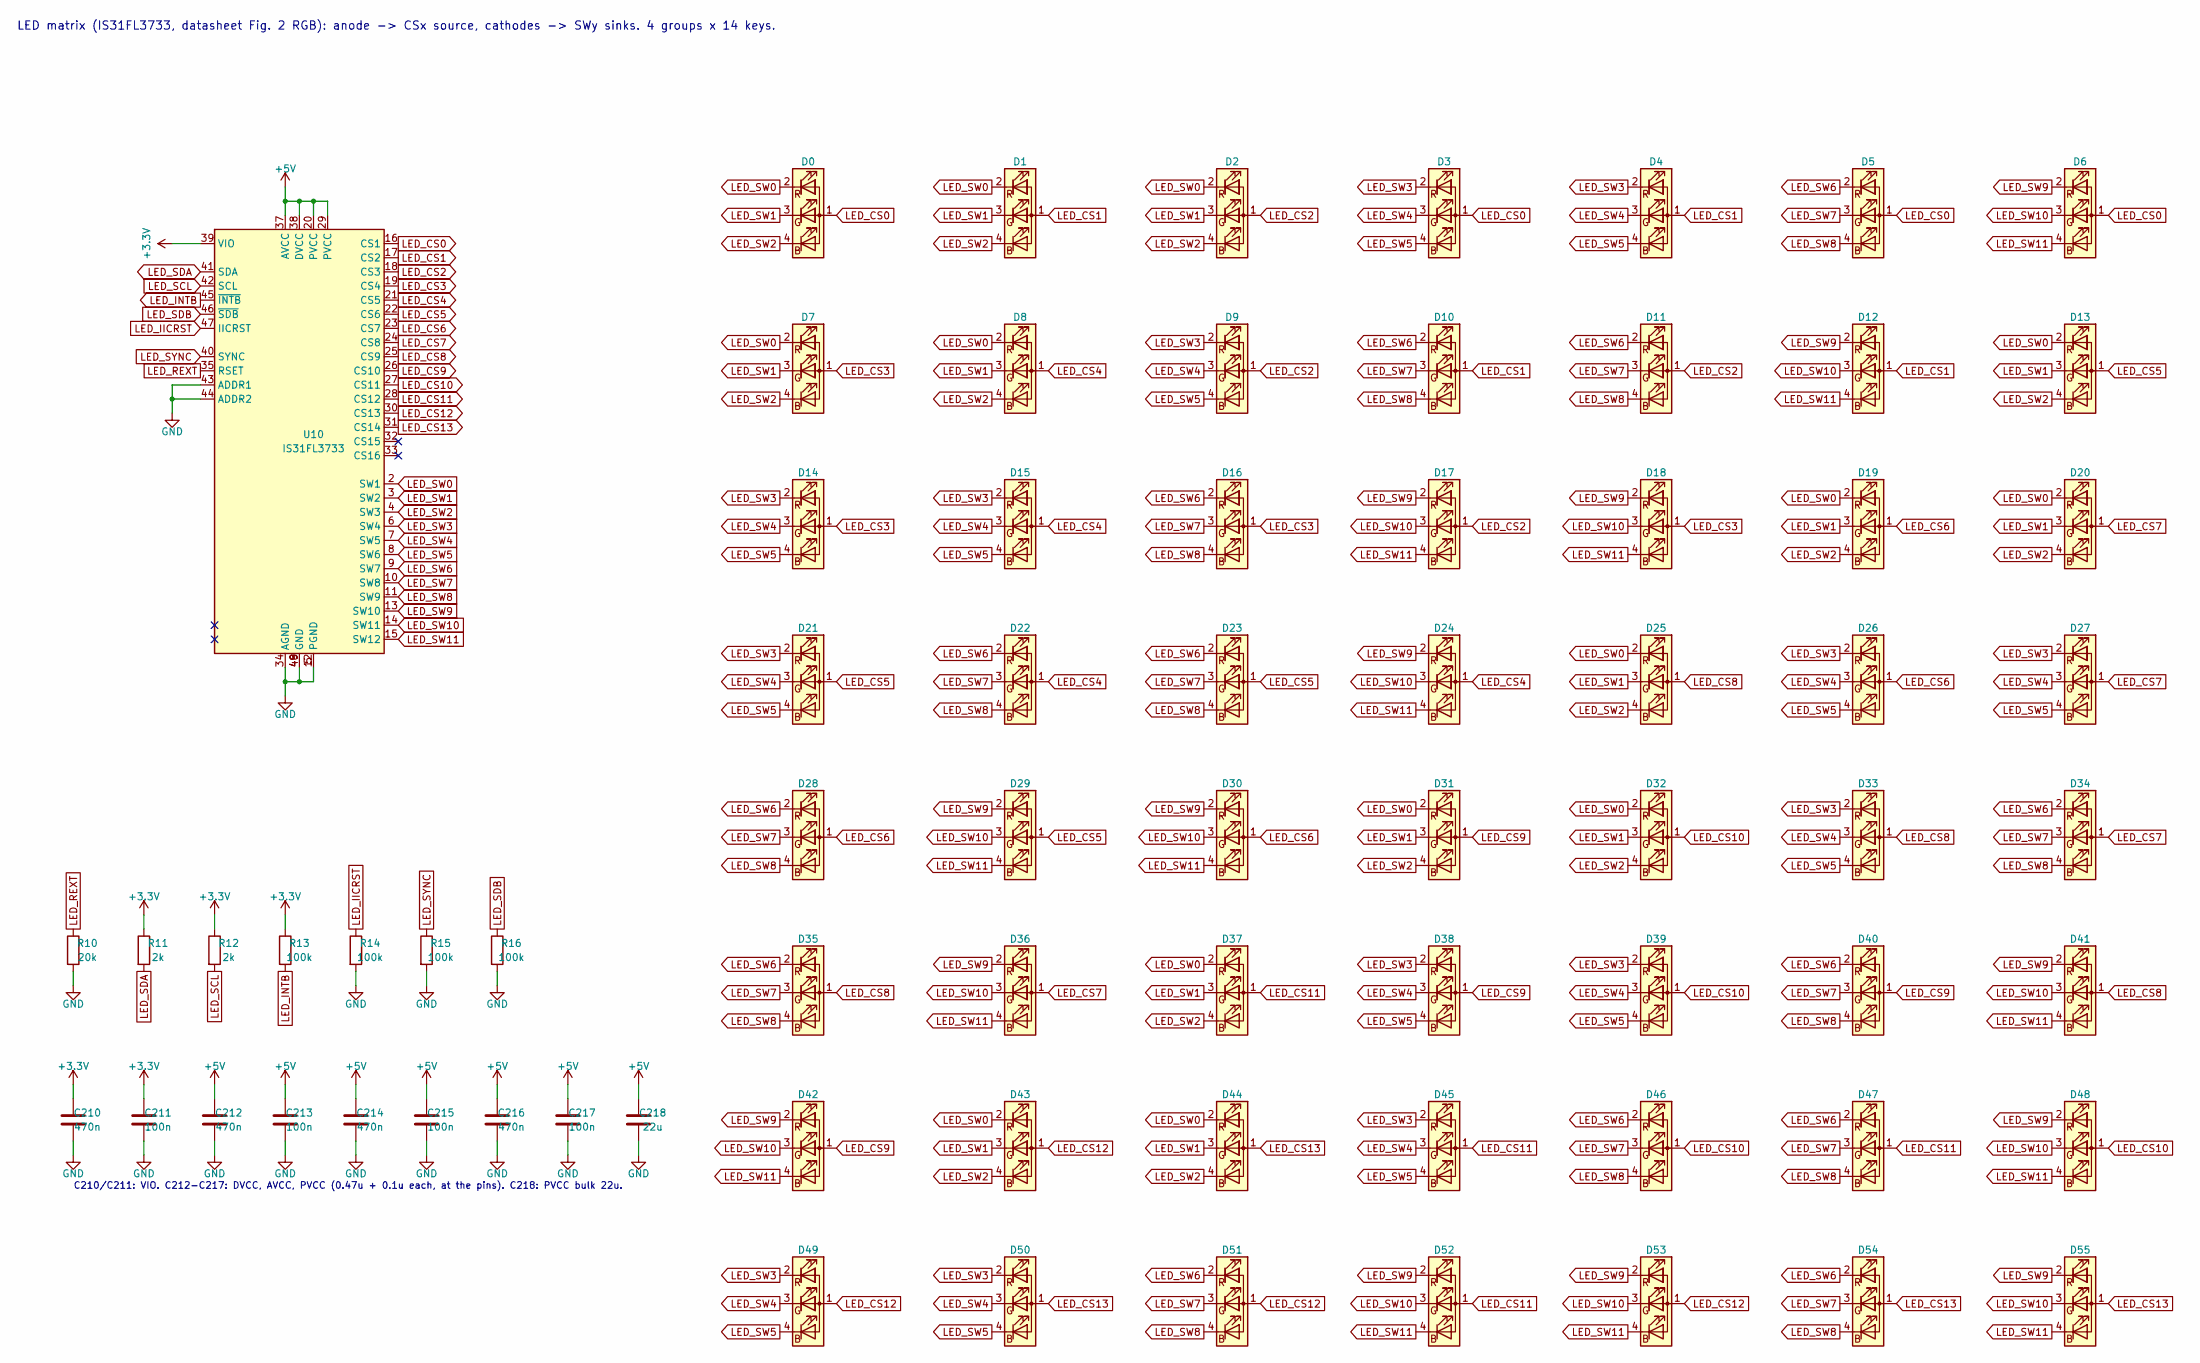
[picture p11: schematic leds.kicad_sch, openxen-m56 - LED matrix]

Parts:
C210, C212, C214, C216: 470n; C_0603_1608Metric; LCSC Part # C1623
C211, C213, C215, C217: 100n; C_0402_1005Metric; LCSC Part # C1525
C218: 22u; C_0805_2012Metric; LCSC Part # C45783
D0, D1, D2, D3, D4, D5, D6, D7, D8, D9, D10, D11, D12, D13, D14, D15, D16, D17, D18, D19, D20, D21, D22, D23, D24, D25, D26, D27, D28, D29, D30, D31, D32, D33, D34, D35, D36, D37, D38, D39, D40, D41, D42, D43, D44, D45, D46, D47, D48, D49, D50, D51, D52, D53, D54, D55: MHT151RGBCT; LED_RGB_1206R_MHT151RGBCT; LCSC Part # C409782
R10: 20k; R_0402_1005Metric; LCSC Part # C25765
R11, R12: 2k; R_0402_1005Metric; LCSC Part # C4109
R13, R14, R15, R16: 100k; R_0402_1005Metric; LCSC Part # C25741
U10: IS31FL3733; QFN-48-1EP_6x6mm_P0.4mm_EP4.2x4.2mm; MPN IS31FL3733-QFLS4-TR; LCSC Part # C506251

Connections:
+3.3V: C210.1, C211.1, R11.1, R12.1, R13.1, U10.39 (VIO); also elsewhere on the board
+5V: C212.1, C213.1, C214.1, C215.1, C216.1, C217.1, C218.1, U10.20 (PVCC), U10.29 (PVCC), U10.37 (AVCC), U10.38 (DVCC); also elsewhere on the board
GND: C210.2, C211.2, C212.2, C213.2, C214.2, C215.2, C216.2, C217.2, C218.2, R10.2, R14.2, R15.2, R16.2, U10.5 (PGND), U10.12 (PGND), U10.34 (AGND), U10.43 (ADDR1), U10.44 (ADDR2), U10.48 (GND), U10.49 (GND); also elsewhere on the board
LED_CS0: D0.1 (A), D3.1 (A), D5.1 (A), D6.1 (A), U10.16 (CS1)
LED_CS1: D1.1 (A), D4.1 (A), D10.1 (A), D12.1 (A), U10.17 (CS2)
LED_CS2: D2.1 (A), D9.1 (A), D11.1 (A), D17.1 (A), U10.18 (CS3)
LED_CS3: D7.1 (A), D14.1 (A), D16.1 (A), D18.1 (A), U10.19 (CS4)
LED_CS4: D8.1 (A), D15.1 (A), D22.1 (A), D24.1 (A), U10.21 (CS5)
LED_CS5: D13.1 (A), D21.1 (A), D23.1 (A), D29.1 (A), U10.22 (CS6)
LED_CS6: D19.1 (A), D26.1 (A), D28.1 (A), D30.1 (A), U10.23 (CS7)
LED_CS7: D20.1 (A), D27.1 (A), D34.1 (A), D36.1 (A), U10.24 (CS8)
LED_CS8: D25.1 (A), D33.1 (A), D35.1 (A), D41.1 (A), U10.25 (CS9)
LED_CS9: D31.1 (A), D38.1 (A), D40.1 (A), D42.1 (A), U10.26 (CS10)
LED_CS10: D32.1 (A), D39.1 (A), D46.1 (A), D48.1 (A), U10.27 (CS11)
LED_CS11: D37.1 (A), D45.1 (A), D47.1 (A), D52.1 (A), U10.28 (CS12)
LED_CS12: D43.1 (A), D49.1 (A), D51.1 (A), D53.1 (A), U10.30 (CS13)
LED_CS13: D44.1 (A), D50.1 (A), D54.1 (A), D55.1 (A), U10.31 (CS14)
LED_IICRST: R14.1, U10.47 (IICRST)
LED_INTB: R13.2, U10.45 (~INTB)
LED_REXT: R10.1, U10.35 (RSET)
LED_SCL: R12.2, U10.42 (SCL); also elsewhere on the board
LED_SDA: R11.2, U10.41 (SDA); also elsewhere on the board
LED_SDB: R16.1, U10.46 (~SDB); also elsewhere on the board
LED_SW0: D0.2 (RK), D1.2 (RK), D2.2 (RK), D7.2 (RK), D8.2 (RK), D13.2 (RK), D19.2 (RK), D20.2 (RK), D25.2 (RK), D31.2 (RK), D32.2 (RK), D37.2 (RK), D43.2 (RK), D44.2 (RK), U10.2 (SW1)
LED_SW1: D0.3 (GK), D1.3 (GK), D2.3 (GK), D7.3 (GK), D8.3 (GK), D13.3 (GK), D19.3 (GK), D20.3 (GK), D25.3 (GK), D31.3 (GK), D32.3 (GK), D37.3 (GK), D43.3 (GK), D44.3 (GK), U10.3 (SW2)
LED_SW2: D0.4 (BK), D1.4 (BK), D2.4 (BK), D7.4 (BK), D8.4 (BK), D13.4 (BK), D19.4 (BK), D20.4 (BK), D25.4 (BK), D31.4 (BK), D32.4 (BK), D37.4 (BK), D43.4 (BK), D44.4 (BK), U10.4 (SW3)
LED_SW3: D3.2 (RK), D4.2 (RK), D9.2 (RK), D14.2 (RK), D15.2 (RK), D21.2 (RK), D26.2 (RK), D27.2 (RK), D33.2 (RK), D38.2 (RK), D39.2 (RK), D45.2 (RK), D49.2 (RK), D50.2 (RK), U10.6 (SW4)
LED_SW4: D3.3 (GK), D4.3 (GK), D9.3 (GK), D14.3 (GK), D15.3 (GK), D21.3 (GK), D26.3 (GK), D27.3 (GK), D33.3 (GK), D38.3 (GK), D39.3 (GK), D45.3 (GK), D49.3 (GK), D50.3 (GK), U10.7 (SW5)
LED_SW5: D3.4 (BK), D4.4 (BK), D9.4 (BK), D14.4 (BK), D15.4 (BK), D21.4 (BK), D26.4 (BK), D27.4 (BK), D33.4 (BK), D38.4 (BK), D39.4 (BK), D45.4 (BK), D49.4 (BK), D50.4 (BK), U10.8 (SW6)
LED_SW6: D5.2 (RK), D10.2 (RK), D11.2 (RK), D16.2 (RK), D22.2 (RK), D23.2 (RK), D28.2 (RK), D34.2 (RK), D35.2 (RK), D40.2 (RK), D46.2 (RK), D47.2 (RK), D51.2 (RK), D54.2 (RK), U10.9 (SW7)
LED_SW7: D5.3 (GK), D10.3 (GK), D11.3 (GK), D16.3 (GK), D22.3 (GK), D23.3 (GK), D28.3 (GK), D34.3 (GK), D35.3 (GK), D40.3 (GK), D46.3 (GK), D47.3 (GK), D51.3 (GK), D54.3 (GK), U10.10 (SW8)
LED_SW8: D5.4 (BK), D10.4 (BK), D11.4 (BK), D16.4 (BK), D22.4 (BK), D23.4 (BK), D28.4 (BK), D34.4 (BK), D35.4 (BK), D40.4 (BK), D46.4 (BK), D47.4 (BK), D51.4 (BK), D54.4 (BK), U10.11 (SW9)
LED_SW9: D6.2 (RK), D12.2 (RK), D17.2 (RK), D18.2 (RK), D24.2 (RK), D29.2 (RK), D30.2 (RK), D36.2 (RK), D41.2 (RK), D42.2 (RK), D48.2 (RK), D52.2 (RK), D53.2 (RK), D55.2 (RK), U10.13 (SW10)
LED_SW10: D6.3 (GK), D12.3 (GK), D17.3 (GK), D18.3 (GK), D24.3 (GK), D29.3 (GK), D30.3 (GK), D36.3 (GK), D41.3 (GK), D42.3 (GK), D48.3 (GK), D52.3 (GK), D53.3 (GK), D55.3 (GK), U10.14 (SW11)
LED_SW11: D6.4 (BK), D12.4 (BK), D17.4 (BK), D18.4 (BK), D24.4 (BK), D29.4 (BK), D30.4 (BK), D36.4 (BK), D41.4 (BK), D42.4 (BK), D48.4 (BK), D52.4 (BK), D53.4 (BK), D55.4 (BK), U10.15 (SW12)
LED_SYNC: R15.1, U10.40 (SYNC)

Notes on the sheet:
LED matrix (IS31FL3733, datasheet Fig. 2 RGB): anode -> CSx source, cathodes -> SWy sinks. 4 groups x 14 keys.
C210/C211: VIO. C212-C217: DVCC, AVCC, PVCC (0.47u + 0.1u each, at the pins). C218: PVCC bulk 22u.
