mcleinn/openxen/hardware/kicad/openxen-m56/openxen-m56.kicad_pcb

## KiCad design hardware/kicad/openxen-m56/openxen-m56.kicad_pcb (continued)

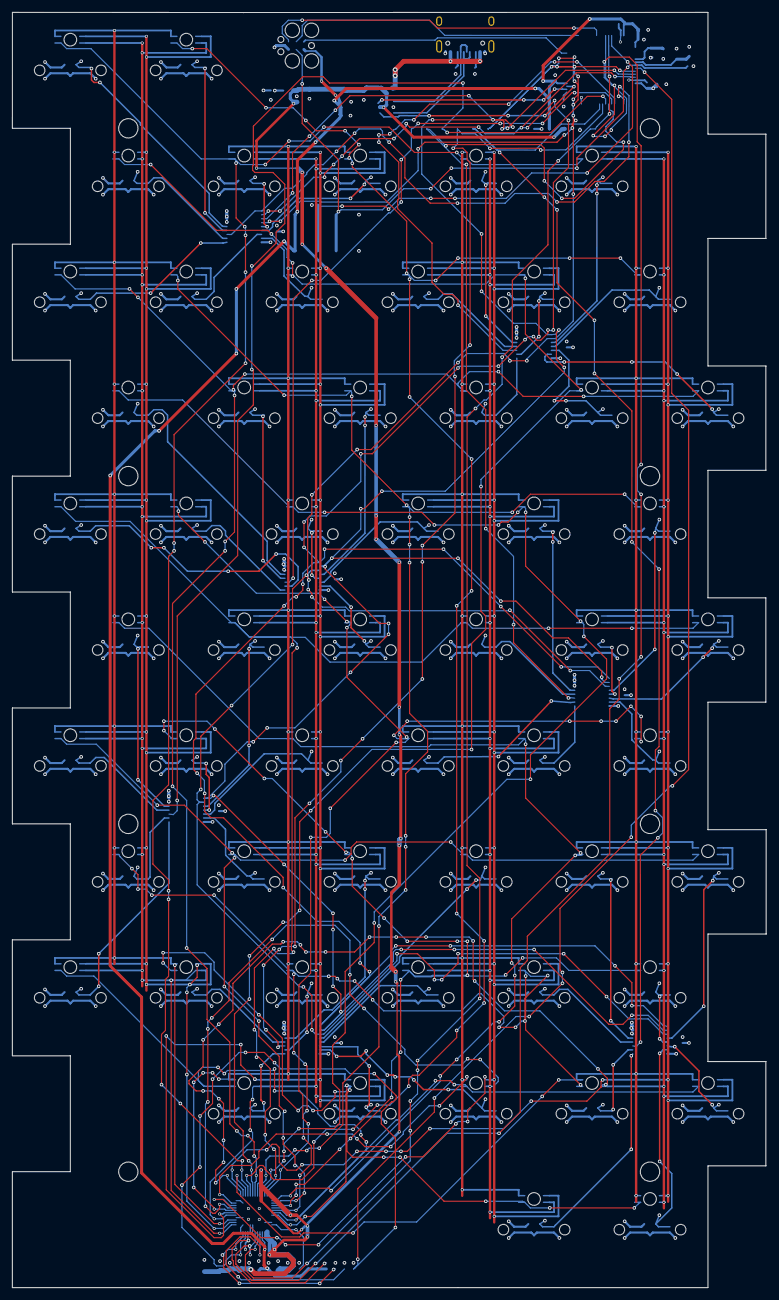
[picture p12: board openxen-m56.kicad_pcb from above]

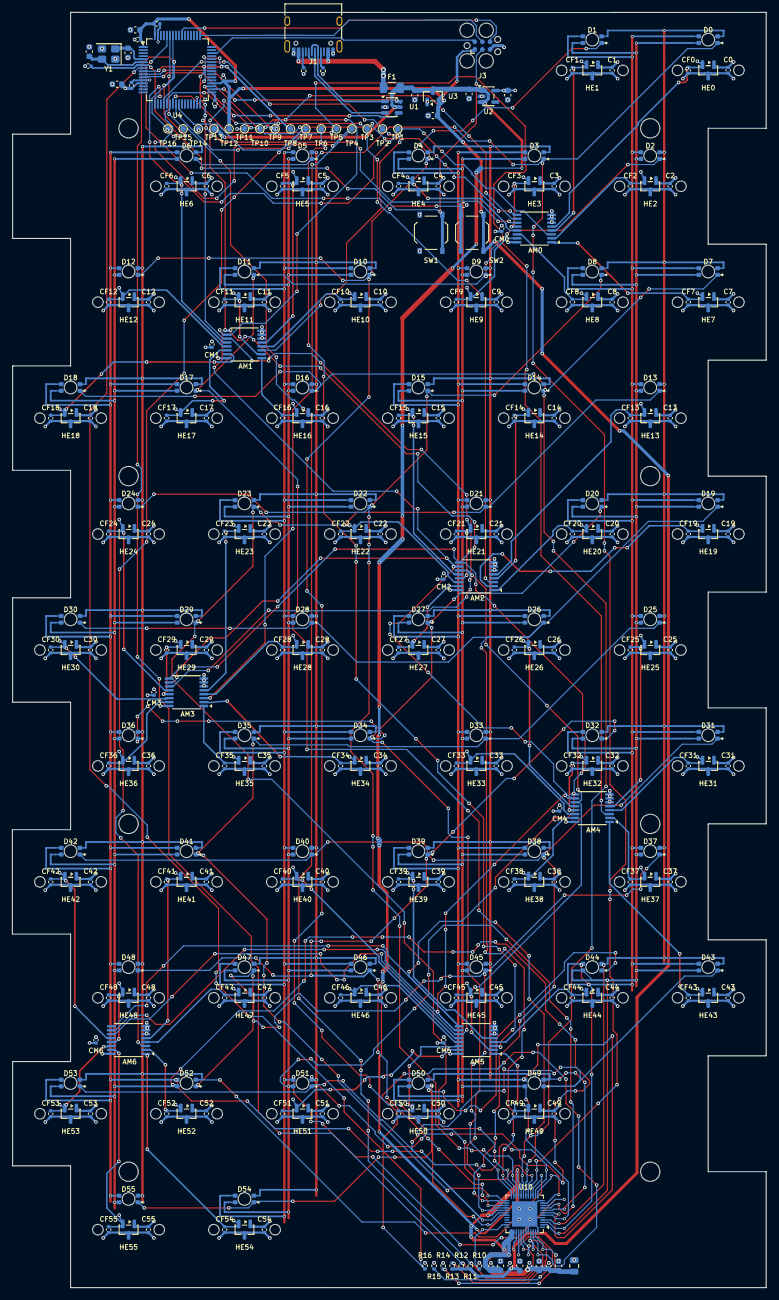
[picture p13: board openxen-m56.kicad_pcb from below]

Board: 4 copper layers, 124.8 x 211.2 mm, 362 parts (298 on the bottom side), 118 nets.

Other parts of the board:
H1, H2, H3, H4, H5, H6, H7, H8: MountingHole_3.2mm_M3_NoPad
K0, K1, K2, K3, K4, K5, K6, K7, K8, K9, K10, K11, K12, K13, K14, K15, K16, K17, K18, K19, K20, K21, K22, K23, K24, K25, K26, K27, K28, K29, K30, K31, K32, K33, K34, K35, K36, K37, K38, K39, K40, K41, K42, K43, K44, K45, K46, K47, K48, K49, K50, K51, K52, K53, K54, K55: Lekker Tikken; SW_Lekker_1u
