mcleinn/openxen/(commit log)

2026-11-06 Phase 0+2: project skeleton, layout spec and generators, reference build
    - git repo skeleton (docs/, layout/, hardware/, firmware/, host/, case/) with
    reference/ (third-party clones, datasheets) and build/ excluded
    - docs/provenance.md: pinned HE60 501871e (v2.1) and libhmk 1d2b2e2, tool versions
    - docs/reference-build.md: unmodified libhmk he60-v2 builds on this machine
    (AT32 platform, 34 KB flash)
    - layout/module.json: single source of truth for the 56-key module, derived from
    the last freexen xenIO board (outline, holes) and xentool's Lumatone key order;
    keys match the existing CNC plates within 0.13 mm
    - generators: extract_freexen.py, build_spec.py, render_preview.py,
    place_mo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
2026-11-06 Plan: LED variant B (IS31FL3741A matrix) chosen for rev 1; unit-cell routing by script
    Claude-Session: https://claude.ai/code/session_01PdDRACeCY9kGjmw9pXGYyu
2026-11-06 Phase 3: generated schematic, footprints, parts with JLCPCB codes
    - hardware/generators: S-expression reader/writer, KiCad 9 schematic helpers,
    gen_project.py (openxen.kicad_sym from HE60, library tables, project),
    gen_schematic.py (HE60 controller block copied verbatim, HE60 sensor and
    mux cells cloned 56x/7x with our mux matrix, IS31FL3733 LED matrix sheet
    from the datasheet's RGB application circuit, LCSC Part # on every symbol)
    - hardware/kicad/lib: SW_Lekker_1u (macrolev/HE60 geometry, Tikken-verified),
    LED_RGB_1206R_MHT151RGBCT (marbastlib geometry, datasheet-confirmed)
    - hardware/parts.json: parts chosen against the JLCPCB database snapshot of
    2026-11-06 (basic parts where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
    [openxen-m56.kicad_sch]
2026-11-06 Phase 4 start: netted board, unit cell routed by script for all 56 keys
    - hardware/generators/apply_netlist.py: headless "update PCB from schematic"
    (creates missing footprints, assigns every pad its net, keeps LCSC field)
    - hardware/generators/route_cell.py: per-key cell routing from actual pad
    positions (sensor -> decoupling/filter caps, GND and +3.3VA vias, LED stubs)
    - place_module: key switches K0..K55 (SW is HE60's buttons), caps beside the
    sensor, footprint lib ids set, mechanical parts marked board-only
    - hardware/kicad/openxen-m56/openxen-m56.kicad_pcb: generated board with all
    283 footprints netted; controller and mux parts still parked
    - DRC: no errors inside the key field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
    [openxen-m56.kicad_pcb]
2026-11-06 Freerouting comparison tooling for one cell (headless DSN/SES via pcbnew), tool provenance
    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
2026-11-06 Phase 4: placement pipeline — HE60 controller blocks copied with routing, muxes and LED driver placed, silk tidy, net classes
    - hardware/generators/build_board.py: one-shot deterministic rebuild
    (project -> schematic -> ERC -> netlist -> board -> blocks -> parts -> cells -> silk -> DRC)
    - copy_he60_blocks.py: HE60's USB, LDO/ESD/fuse, MCU/crystal, buttons and TC2030
    sub-blocks placed with their internal tracks/vias; dead-end stubs pruned
    - place_rest.py: 7 muxes in the band south of a host key per group, LED driver
    block in the bottom-left strip
    - tidy_silk.py: values and part-number fields hidden, references mirrored/placed
    - gen_project.py: net classes with widths (Power5V 0.8, Pow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
    [openxen-m56.kicad_pcb, openxen-m56.kicad_sch]
2026-11-06 Schematic: hierarchical sheets, test points, overlap-free labels; routing pipeline scripts
    - gen_schematic: root + controller/sensors/muxes/LEDs sub-sheets; LED driver support
    parts and 56 LED cells laid out without label/reference overlaps; global labels follow
    the pin direction; DFT test points TP1..TP16 (1 mm pads, bottom) in two rows
    - kicad_sch: power symbol value placement by rotation, label justification by rotation
    - add_zones (GND In1.Cu, +3.3VA In2.Cu, optional bottom pour), freeroute_board
    (headless DSN/SES, fanout disabled), render_screenshots (regenerates build/screenshots)
    - build_board --route: planes + Freerouting + bottom pour as pipeline steps
    - parts.json: LED driver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
    [controller.kicad_sch, leds.kicad_sch, muxes.kicad_sch, openxen-m56.kicad_sch, sensors.kicad_sch]
2026-11-06 Fix net classes/design rules being lost by headless pcbnew saves; silkscreen rules; protected wires for Freerouting
    - gen_project: KiCad 9 ignores net classes without "priority"/"diff_pair_via_gap"; the
    project now carries Default/Analog/Power5V/Power3V3/LED_SW/LED_CS/USB with their widths
    - every pcbnew.SaveBoard(..., True): never rewrite the .kicad_pro (it dropped the classes
    and the 0.15 mm clearance / 0.25 mm edge / 0.2 mm hole rules on each save)
    - freeroute_board: existing wires exported as "protect", fanout stage off, net classes in
    the DSN (widths 0.8/0.5/0.3/0.25 mm) - earlier runs routed everything at 0.2 mm
    - tidy_silk: 0.8 mm / 0.15 mm refs (JLCPCB minimum), LED outline sil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
2026-11-06 Board: GND/+3.3VA planes, silkscreen cleanup applied; Freerouting heap/thread/timeout options
    DRC with the project rules: 0 errors, 462 open ratsnest items (autorouting pending),
    parity 0, warnings only the 199 intentional 1 mm LED stubs and the USB silk at the edge.
    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
    [openxen-m56.kicad_pcb]
2026-11-06 Silk: separate the SW2 reference from D9
    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
    [openxen-m56.kicad_pcb]
2026-11-06 Freerouting: inner plane layers exported as power layers (route only on F.Cu/B.Cu)
    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
2026-11-06 Plane nets: "Plane" net class (GND, +3.3VA), +3.3VA pads stitched to the plane by script, autorouter ignores the plane nets
    - add_plane_vias.py: stub + via from every +3.3VA pad whose copper has no via yet (18 on this
    board: mux VCC pins and caps, LDO output, VDDA cap, TP11); GND is served by the bottom pour
    - freeroute_board: --router.ignore_net_classes=Plane; without the plane polygons the router
    would otherwise try to route GND and +3.3VA on the outer layers (674 instead of 559 items)
    - DRC: 0 errors, parity 0
    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
    [openxen-m56.kicad_pcb]
2026-11-06 freeroute_board: route in rounds, board saved after each round
2026-11-06 freeroute_board: fix print
2026-11-06 freeroute_board: export NPTH keepouts at the bare hole size (KiCad adds 0.4 mm, Freerouting adds 0.2 mm again: 224 phantom violations on the LED stubs)
2026-11-07 Scripted LED sink buses: 12 straight SW lines on F.Cu with per-LED feeders and vias
    route_led_sw.py: per stripe three 0.4 mm lines at x_m+2.3 (R), x_m+3.0 (G), x_m-2.3 (B)
    on the empty top layer, clear of LED holes, guide holes, cell vias and the M3 holes; each LED
    feeds its three cathodes on B.Cu (middle keys: vias on the stubs; left keys: feeders along
    the stub rows, B under the LED; right keys: lanes in the LED/sensor band) to 0.5/0.3 vias on
    the lines. DRC 0 errors, parity 0, open connections 444 -> 288. Driver fan-in left open.
    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
    [openxen-m56.kicad_pcb]
2026-11-07 Spatial mux groups: 7 compact 8-key clusters, side-aware channels; LED sink lines and planes in the standard build
    - build_spec: capacitated k-means (8 keys per mux), mux under the key nearest the cluster
    centre, left/right pin columns assigned to the left/right keys in pin order. Farthest key
    per mux 58 mm -> 39 mm, total analog length -27 %. Spec records each mux's position.
    - place_rest uses the spec position; build_board runs route_led_sw and the planes always
    - keyboard.json regenerated (libhmk schema OK); board rebuilt: DRC 0 errors, parity 0
    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
    [controller.kicad_sch, leds.kicad_sch, muxes.kicad_sch, openxen-m56.kicad_pcb, openxen-m56.kicad_sch, sensors.kicad_sch]
2026-11-07 Consistency test suite (30 tests), firmware polarity fix, dangling-stub fix in the HE60 copy
    tests/: spec (key field, mux partition, channel/pin-column order, mux placement, LED matrix),
    netlist vs spec and datasheet pin maps (sensor cells, 4051 Y/S/INH pins, MCU input/select
    pins, LED anode/R/G/B, IS31FL3733 CS/SW, I2C/SDB/ADDR), firmware JSON vs spec + libhmk schema,
    board (DRC 0 errors, parity 0, known warnings only, single-sided assembly, placement vs spec,
    no tracks on planes, track/via minimums, every LED cathode on its sink line). build_board.py
    runs the suite as its last step.
    Found and fixed by the tests:
    - keyboard.json had invert_adc false; the GH39FKSW reads inverted. Now taken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
    [controller.kicad_sch, leds.kicad_sch, muxes.kicad_sch, openxen-m56.kicad_pcb, openxen-m56.kicad_sch, sensors.kicad_sch]
2026-11-07 Firmware builds for openxen-m56; matrix orientation and keymap field fixed; ELF-level tests
    - libhmk's keyboard.json matrix is [mux input][select channel] (make.py transposes it into the
    C table); ours was [channel][input]. Spec, schematic generator and firmware JSON now use
    libhmk's order. The keymap was under "default_keymap", which libhmk silently ignores; now
    "keymap".
    - firmware/build_firmware.py: builds libhmk at the pinned commit in build/fw/libhmk (reference
    clone untouched) with our board dir; 32 KB flash, 12 KB RAM. Part of build_board.py.
    - tests/test_firmware_binary.py reads mux_input_matrix, mux_select_pins and
    mux_input_channels out of firmware.elf and checks them aga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
    [controller.kicad_sch, leds.kicad_sch, muxes.kicad_sch, openxen-m56.kicad_pcb, openxen-m56.kicad_sch, sensors.kicad_sch]
2026-11-07 Production files in the pipeline (Fabrication Toolkit CLI) with tests; testing docs; plan update
    - hardware/fab/make_fab.py: Gerber/drill zip, BOM, positions from a copy of the board
    - tests/test_fab.py: BOM/CPL complete and bottom-only, positions = board, identical cell
    rotations, LCSC parts exist/assemblable/in stock for 2 boards, all Gerber layers, NPTH count
    - build_board.py: ... -> firmware build -> production files -> 39 tests, all green from scratch
    - docs/testing.md; PROJECT_PLAN phases 4, 6, 7; provenance (Fabrication Toolkit, TraceMaker)
    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
    [controller.kicad_sch, leds.kicad_sch, muxes.kicad_sch, openxen-m56.kicad_pcb, openxen-m56.kicad_sch, sensors.kicad_sch]
2026-11-07 Analog stream: own HID interface, one timestamped report per scan; reference decoder; tests
    - firmware/libhmk/: openxen_stream_core.c (frame ring between scan interrupt and main loop,
    report packing, us clock from the cycle counter; hardware independent), openxen_stream.c
    (scan-complete hook, sends from its own 144-byte buffer since libhmk needs TinyUSB's HID
    buffer at 64), apply_openxen.py (4th HID interface + descriptors with a full-speed variant,
    scan hook in the AT32 analog driver, main loop; exact search/replace at build time)
    - docs/stream-protocol.md: report layout (magic, version, flags, sequence, dropped, device
    timestamp, 56 raw values, rotating calibration), USB paramete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
    [apply_openxen.py, openxen_stream.c, openxen_stream.h, openxen_stream_core.c]
2026-11-07 LED driver: IS31FL3733 core + non-blocking I2C glue, host commands on the openxen interface, tests
    - firmware/libhmk/src/openxen_led_core.c (hardware independent): command parsing (pixels
    staged + show, config, keepalive), gamma 2.2, press highlight, power budget through the
    driver's global current (never exceeded, also between writes), host timeout fallback,
    minimal register writes with the page-lock protocol, re-init after I2C errors
    - openxen_led.c: I2C1 PB6/PB7 (AF4) at ~385 kHz, SDB on PC0, one byte per main-loop pass
    - key -> LED lines generated from layout/module.json (openxen_led_map.h)
    - libhmk edits: openxen interface IN+OUT, LED dispatch in tud_hid_set_report_cb, main loop;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
    [apply_openxen.py, openxen_led.c, openxen_led.h, openxen_led_core.c, openxen_stream.c]
2026-11-07 Ignore the machine-specific TraceMaker skill folder
    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
2026-11-07 Net classes: 0.2 mm for Default, LED_CS and LED_SW fan-in (IS31FL3733 QFN pads)
    The LED driver's pads are 0.2 mm wide at 0.4 mm pitch: with 0.2 mm clearance a track
    entering a pad can be at most 0.2 mm wide, so all ~32 driver connections were unroutable
    with the old 0.25/0.3/0.5 mm classes. The scripted LED sink lines stay 0.4 mm (locked);
    tests: track floor 0.2 mm, sink-line width checked on the long F.Cu lines only.
    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
    [controller.kicad_sch, leds.kicad_sch, muxes.kicad_sch, openxen-m56.kicad_pcb, openxen-m56.kicad_sch, sensors.kicad_sch]
2026-11-07 Cell routing: escape via for every sensor output (enclosed on B.Cu by the GND bar, guide hole and LED sink lanes)
    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
    [controller.kicad_sch, leds.kicad_sch, muxes.kicad_sch, openxen-m56.kicad_pcb, openxen-m56.kicad_sch, sensors.kicad_sch]
2026-11-07 LED driver block: support parts below the QFN so its left/top/right edges are free for the 26 LED lines; route import step
    The autorouter's open list (261/289 routed) was entirely at the driver: caps above the top
    edge and the resistor row beside the right edge walled in 17 LED pins.
    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
    [controller.kicad_sch, leds.kicad_sch, muxes.kicad_sch, openxen-m56.kicad_pcb, openxen-m56.kicad_sch, sensors.kicad_sch]
2026-11-07 Board fully routed: LED driver fan-out + breakout, scripted VBUS, TraceMaker routes replayed in the build
    - route_led_driver.py: IS31FL3733 (U10, 0.4 mm QFN) fanned out on all four edges to staggered
    via rows; GND pins onto the exposed pad (4 vias). Support caps/resistors in one row below.
    - route_vbus.py: VBUS J1 -> F1 at 0.8 mm on F.Cu (the router squeezed it to 0.2 mm).
    - import_routes.py: --capture stores an accepted TraceMaker result in
    hardware/routes/openxen-m56.routes.json; build_board.py replays it (refuses if the placement
    moved; --no-routes builds the board for a new routing run). Freerouting step removed.
    - widen_power.py: widens necked-down +5V/VBUS router tracks where cle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
    [controller.kicad_sch, leds.kicad_sch, muxes.kicad_sch, openxen-m56.kicad_pcb, openxen-m56.kicad_sch, sensors.kicad_sch]
2026-11-07 Fuse 2 A hold (1206L200/16NR); datasheet pin and power tests
    F1: worst-case module current is ~1.15 A (56 sensors at 9 mA max, LEDs at
    the 600 mA firmware cap, MCU), above a warm 1 A-hold polyfuse. Same 1206
    footprint, layout unchanged, stored routes replay.
    New tests against datasheet facts (tests/facts.py):
    - IS31FL3733: all 48 pins + EP by pin number, supplies, NC pins, IICRST pull-down
    - MHT151RGBCT: anode pad's neighbours carry B/R/G per the datasheet pad pattern
    - sensor SOT-23 pin geometry
    - polyfuse hold current (derated) >= worst-case module current
    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
    [controller.kicad_sch, leds.kicad_sch, muxes.kicad_sch, openxen-m56.kicad_pcb, openxen-m56.kicad_sch, sensors.kicad_sch]
2026-11-07 Fix mirrored LED footprint, USB-C to the right half, board re-routed
    LED (critical, found by an independent review): the MHT151RGBCT footprint
    was the datasheet's lens-side drawing, i.e. mirrored for a reverse-mount
    part on B.Cu. Every LED would have had its anode on a blue sink line. Pads
    now follow the LED's bottom view (same as marbastlib LED_MX_1206R);
    route_led_sw.py follows the swapped rows (B over the top of the LED, R/G
    lanes swapped for right-hand keys). The LED test now checks handedness, not
    just distances.
    USB-C J1 at x = 75 mm (right half of the top edge, case bay); LDO/ESD/fuse
    row 20 mm left, TC2030 to the strip's top-left corner, MCU unchanged.
    route_vbus.py handles J1 west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
    [controller.kicad_sch, leds.kicad_sch, muxes.kicad_sch, openxen-m56.kicad_pcb, openxen-m56.kicad_sch, sensors.kicad_sch]
2026-11-07 Offline JLCPCB placement check; per-part rotation/position corrections
    check_jlc_placement.py places each part's EasyEDA footprint (the one JLC
    uses) at the CPL position/rotation and compares it with our footprint:
    pads, pin 1 (LED: all pins, USB-C: signal pads) and reference point. The
    Fabrication Toolkit's generic table was wrong for 5 part types: MHT151RGBCT
    (180, anode on the green pad), IS31FL3733 QFN-48 (90), USBLC6 SOT-23-6 and
    TLV75733 SOT-23-5 (90), USB-C origin (1.68 mm). jlc_corrections.json holds
    the fixes; make_fab.py writes them as FT Rotation/Position Offset on its
    board copy. New test runs the check (EasyEDA cache in gitignored reference/).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
