mcleinn/openxen/(notices)

Notices in the files:
hardware/kicad/openxen-m56/leds.kicad_sch:
openxen (GPL-3.0)
